ToneAlchemy/BiasMeter/IMAGES/BIAS_METER PHOTO.jpg

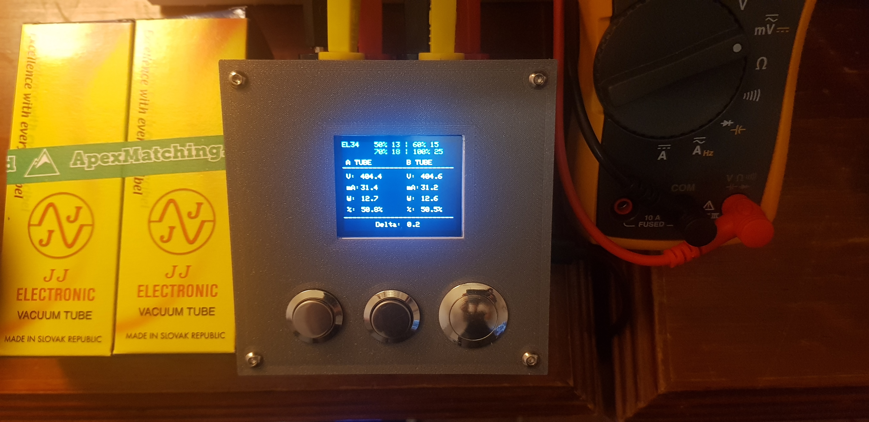
IMAGES/BIAS_METER PHOTO.jpg
