ToneAlchemy/BiasMeter/IMAGES/EL34_BiasMeter_Reading.jpg

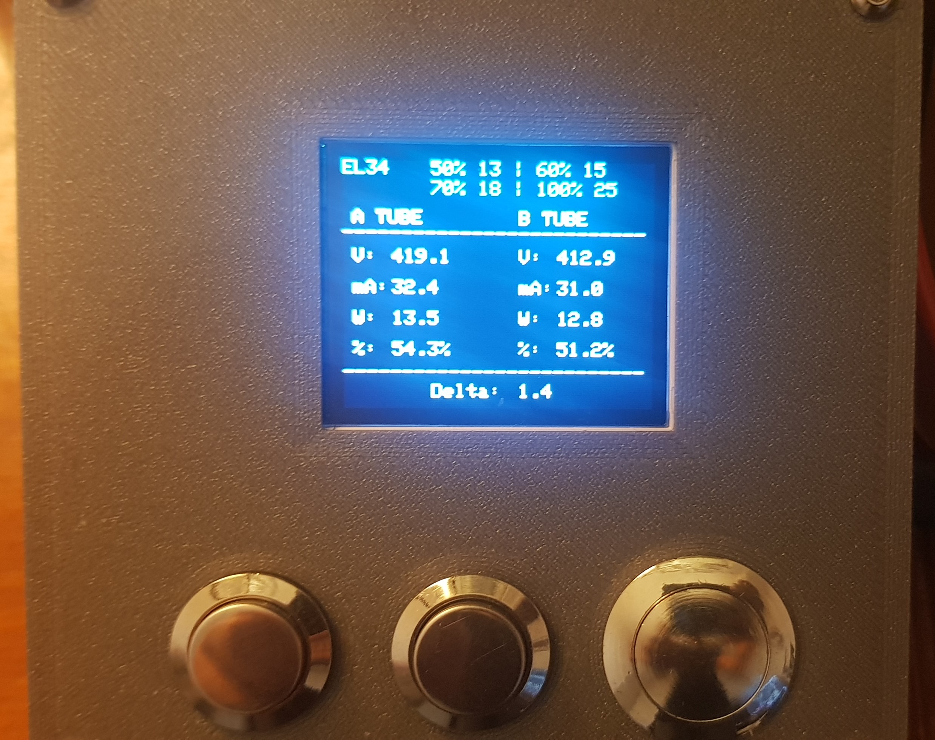
IMAGES/EL34_BiasMeter_Reading.jpg
