ToneAlchemy/BiasMeter/IMAGES/Tube_Manager-DELETE_Profile_Confirmation.jpg

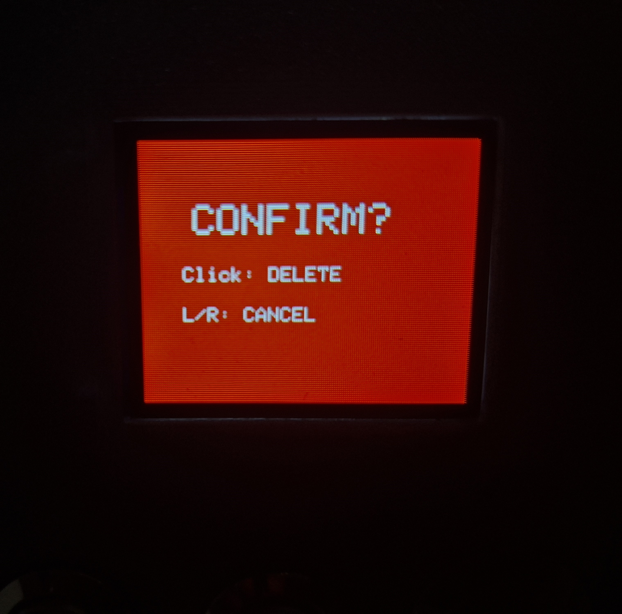
IMAGES/Tube_Manager-DELETE_Profile_Confirmation.jpg
