ToneAlchemy/BiasMeter/IMAGES/Tube_Manager-Deleted_Profile.jpg

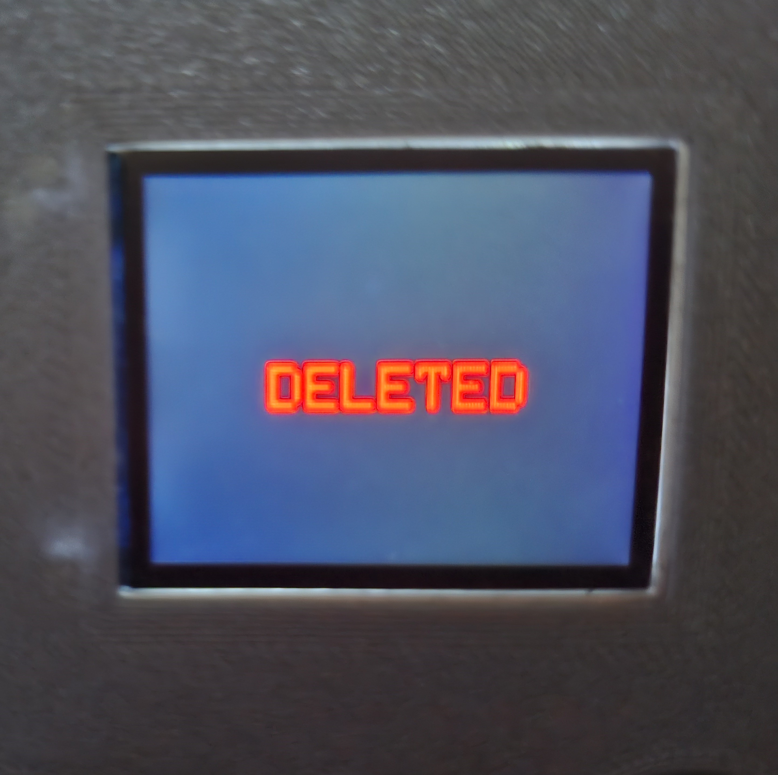
IMAGES/Tube_Manager-Deleted_Profile.jpg
