ToneAlchemy/BiasMeter/IMAGES/Tube_Manager-Edit_profile.jpg

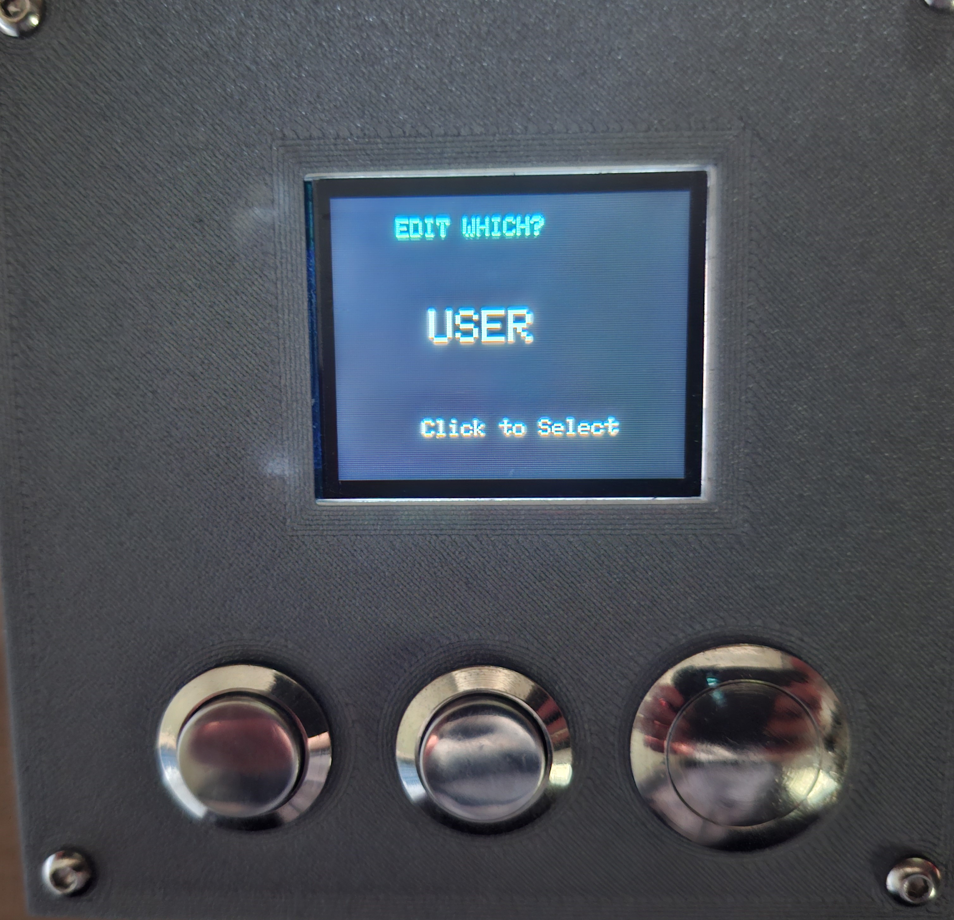
IMAGES/Tube_Manager-Edit_profile.jpg
