ToneAlchemy/BiasMeter/HARDWARE - PCB KICAD/BiasMeter_Enclosure_STL/BIASMETER_BOX_TOP.stl

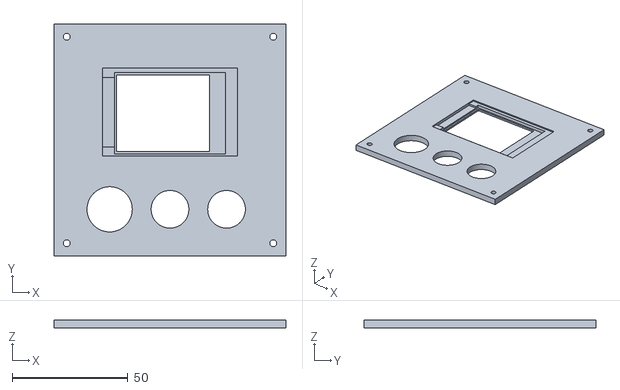
[picture p20: CAD file, 2026-01-05]
HARDWARE - PCB KICAD/BiasMeter_Enclosure_STL/BIASMETER_BOX_TOP.stl
100.0 x 100.0 x 3.50
