ToneAlchemy/BiasMeter/HARDWARE - PCB KICAD/BiasMeter_Enclosure_STL/BIASMETER_BOX_BOTTOM.stl

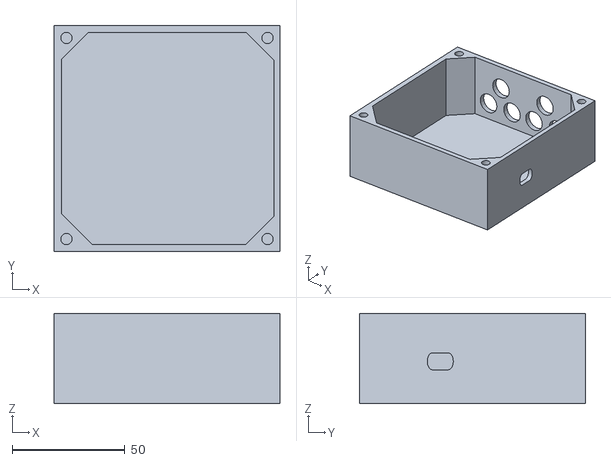
[picture p21: CAD file, 2026-01-05]
HARDWARE - PCB KICAD/BiasMeter_Enclosure_STL/BIASMETER_BOX_BOTTOM.stl
100.0 x 100.0 x 40.0
