ToneAlchemy/BiasMeter/IMAGES/BiasMeter_Setup_1.jpg

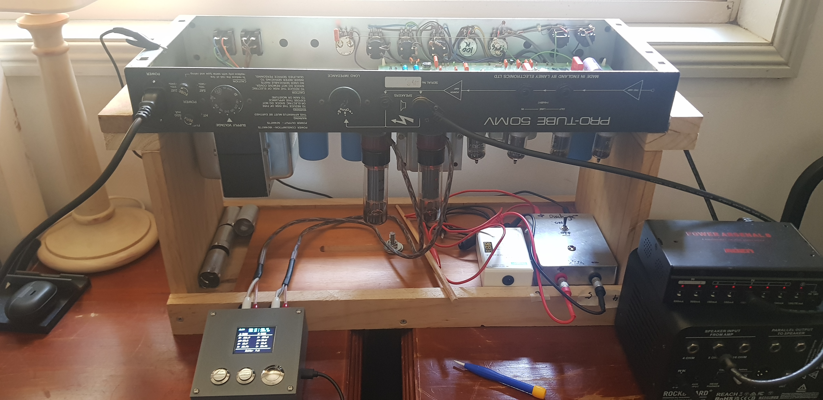
IMAGES/BiasMeter_Setup_1.jpg
