ToneAlchemy/BiasMeter/IMAGES/BiasMeter_Setup_2.jpg

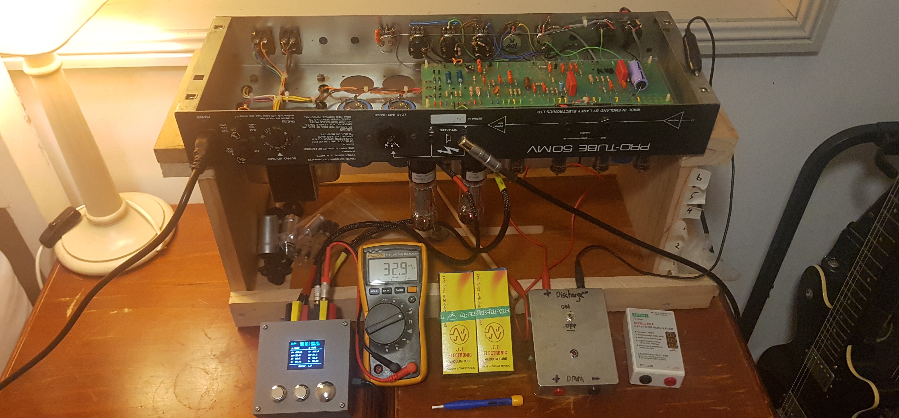
IMAGES/BiasMeter_Setup_2.jpg
