ToneAlchemy/BiasMeter/HARDWARE - PCB KICAD/BiasMeter - KICAD/Kicad - Bias_Meter - Project Files/BiasMeter_InputProtection_v3.kicad_pcb

## KiCad design HARDWARE - PCB KICAD/BiasMeter - KICAD/Kicad - Bias_Meter - Project Files/BiasMeter_InputProtection_v3.kicad_pcb (2026-01-08)

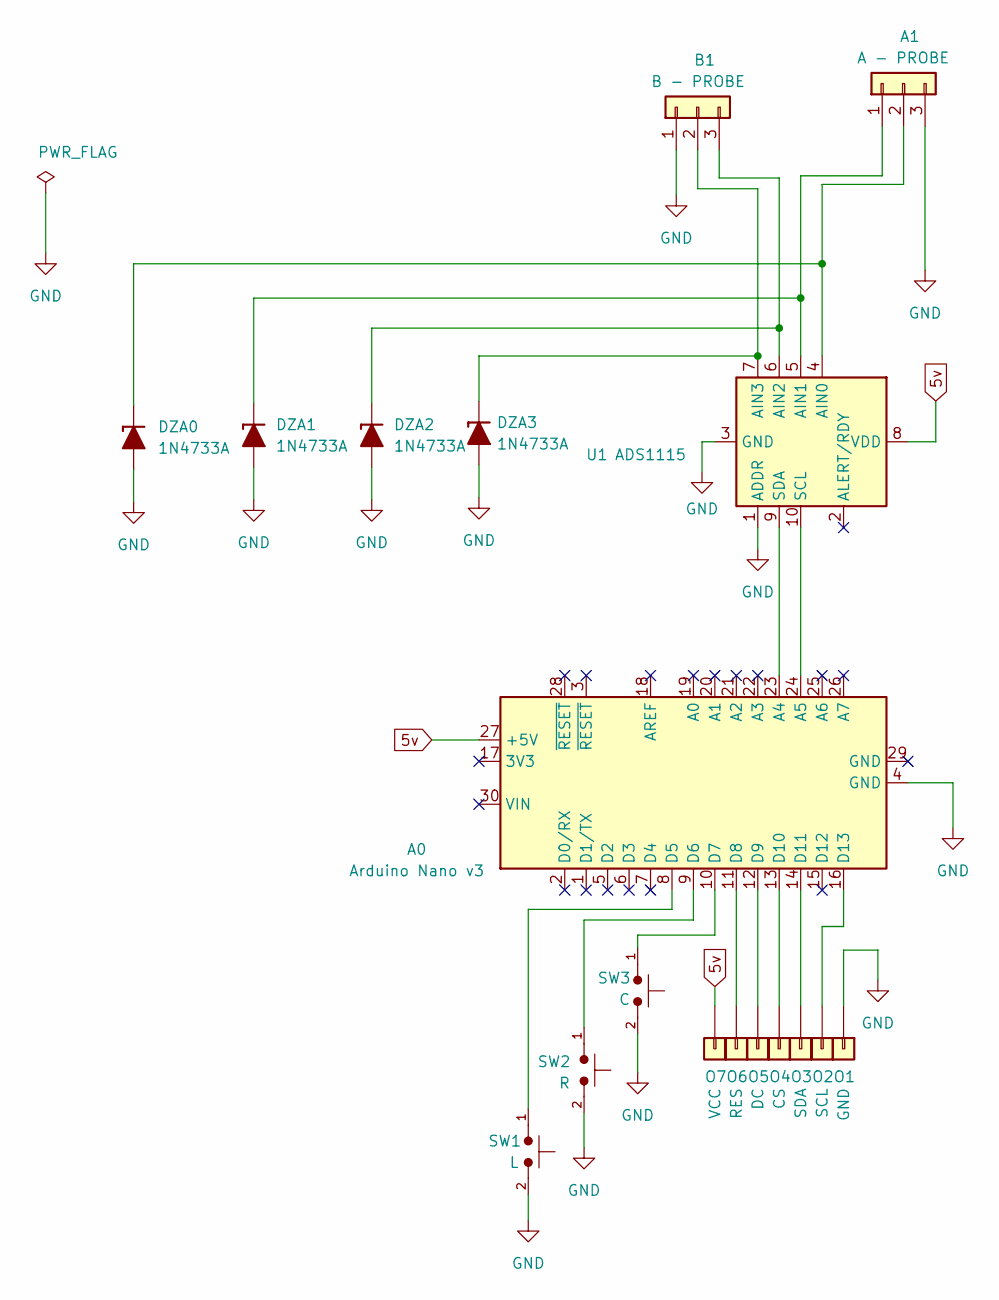
[picture p24: schematic BiasMeter_InputProtection_v3.kicad_sch, Bias Meter Input Protection]

Parts:
A0: Arduino Nano v3; Arduino_Nano
A1: A - PROBE; PinHeader_1x3_P2.54_Drill1.1mm
B1: B - PROBE; PinHeader_1x3_P2.54_Drill1.1mm
DZA0, DZA1, DZA2, DZA3: 1N4733A; D_DO-41_SOD81_P10.16mm_Horizontal_Zener
O1: GND; TestPoint_THTPad_D2.0mm_Drill1.0mm
O2: SCL; TestPoint_THTPad_D2.0mm_Drill1.0mm
O3: SDA; TestPoint_THTPad_D2.0mm_Drill1.0mm
O4: CS; TestPoint_THTPad_D2.0mm_Drill1.0mm
O5: DC; TestPoint_THTPad_D2.0mm_Drill1.0mm
O6: RES; TestPoint_THTPad_D2.0mm_Drill1.0mm
O7: VCC; TestPoint_THTPad_D2.0mm_Drill1.0mm
SW1: L; PinHeader_1x2_P2.54mm
SW2: R; PinHeader_1x2_P2.54mm
SW3: C; PinHeader_1x2_P2.54mm
U1: ADS1115; Adafruit_ADS1115_NEW

Connections:
5v: A0.27 (+5V), O7.1, U1.8 (VDD)
GND: A0.4 (GND), A1.3, B1.1, DZA0.2 (A), DZA1.2 (A), DZA2.2 (A), DZA3.2 (A), O1.1, SW1.2, SW2.2, SW3.2, U1.1 (ADDR), U1.3 (GND)
unnamed: A0.23 (A4), U1.9 (SDA)
unnamed: A0.24 (A5), U1.10 (SCL)
unnamed: A0.8 (D5), SW1.1
unnamed: A0.9 (D6), SW2.1
unnamed: A0.10 (D7), SW3.1
unnamed: A0.11 (D8), O6.1
unnamed: A0.12 (D9), O5.1
unnamed: A0.13 (D10), O4.1
unnamed: A0.14 (D11), O3.1
unnamed: A0.16 (D13), O2.1
unnamed: A1.1, DZA1.1 (K), U1.5 (AIN1)
unnamed: A1.2, DZA0.1 (K), U1.4 (AIN0)
unnamed: B1.2, DZA3.1 (K), U1.7 (AIN3)
unnamed: B1.3, DZA2.1 (K), U1.6 (AIN2)

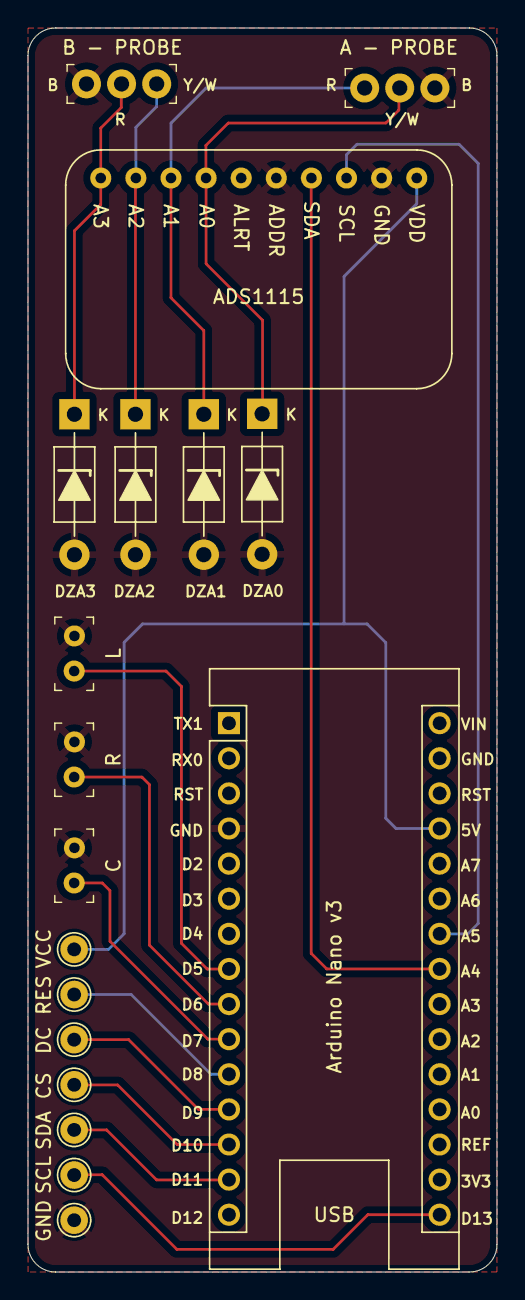
[picture p25: board BiasMeter_InputProtection_v3.kicad_pcb from above]

Board: 2 copper layers, 33.9 x 90.0 mm, 18 parts (0 on the bottom side), 16 nets.
