ToneAlchemy/BiasMeter/(commit log)

2026-01-05 Schematic and Pcb design
    Kicad schematic and pcb designs
2026-01-05 Create Bill of Materials (BOM) for the BIASMETER.txt
2026-01-05 Update folders
    [BIASMETER_BOX_BOTTOM.stl, BIASMETER_BOX_TOP.stl]
2026-01-05 Update attribution for Dual Channel Arduino Bias Tester
2026-01-05 Add README for Arduino Tube Amp Bias Meter
    Added comprehensive documentation for the Arduino Tube Amp Bias Meter, including safety warnings, features, calibration guide, and usage instructions.
2026-01-05 Refactor high voltage safety warning in README
    Consolidate high voltage safety warning into a single section for clarity and emphasis.
2026-01-05 Folder renamed
    [BIASMETER_BOX_BOTTOM.stl, BIASMETER_BOX_TOP.stl]
2026-01-05 Change Arduino Nano pinout image to URL
    Updated Arduino Nano pinout image link to use a URL.
2026-01-05 Update README with download links for STL and PCB files
    Added download links for STL and PCB files in the README.
2026-01-05 Update Bill of Materials (BOM) for the BIASMETER.txt
2026-01-05 v11.4
    Minor fixes and code clean up.
    [BiasMeter-WTD-v11.4.1.ino, BiasMeter_v11.3-PLATINUM.ino, BiasMeter_v11.4.ino]
2026-01-06 Fix image link for PCB schematic in README
2026-01-06 Update DMM measurement procedure in README
    Added steps to measure DMM lead resistance and calculate actual resistance value for improved accuracy.
2026-01-06 Update README with detailed tube dissipation info
    Clarified instructions for setting Max Plate Dissipation and provided typical values for additional tube types.
2026-01-06 Update README with safety and wiring details
    Added critical safety information for capacitor discharge and probe wiring instructions.
2026-01-06 Add safety gear recommendations to README
    Added a section on recommended safety gear for working with live amplifiers, including isolation transformer, dim bulb limiter, and variac.
2026-01-06 Enhance Variac description in README
    Expanded the explanation of the Variac, detailing its uses for voltage stabilization and soft start/reforming.
2026-01-06 Enhance safety instructions and fix formatting
    Added a note about using a dedicated Capacitor Discharge Tool for safety and corrected formatting in the recommended settings section.
2026-01-07 Enhance safety instructions in README
    Added DIY tip for building a capacitor discharge tool.
2026-01-07 Enhance README with Watchdog Timer details and fixes
    Added a technical deep dive section on the Watchdog Timer and troubleshooting tips for boot loop issues with older Arduino Nano boards.
2026-01-07 Add theory of operation section to README
    Added a section explaining the theory of operation for the Bias Meter, detailing how it measures high-voltage tube amplifiers, including voltage measurement, bias current measurement, and dissipation calculation.
2026-01-07 Revise firmware version and add pinout image
    Updated the Arduino Nano firmware version in the instructions and added an image of the octal tube socket pinout.
2026-01-08 Kicad Files and Gerber Order Files
    Put Kicad Project Files and Gerber files in folder.
    [BiasMeter_InputProtection_v3-B_Cu.gbr, BiasMeter_InputProtection_v3-B_Mask.gbr, BiasMeter_InputProtection_v3-B_Paste.gbp, BiasMeter_InputProtection_v3-B_Paste.gbr, BiasMeter_InputProtection_v3-B_Silks.gbr, BiasMeter_InputProtection_v3-Edge_Cuts.gbr, BiasMeter_InputProtection_v3-Edge_Cuts.gm1, BiasMeter_InputProtection_v3-F_Cu.gbr]
2026-02-01 Add safety information for powering the device
    Added section on powering the device for safety.
2026-02-10 Update DIY Tip for Capacitor Discharge Tool resistor values
